schnommus/EMC_5uH_LISN/5uH_LISN.kicad_pcb

## KiCad design 5uH_LISN.kicad_pcb (2024-11-13)

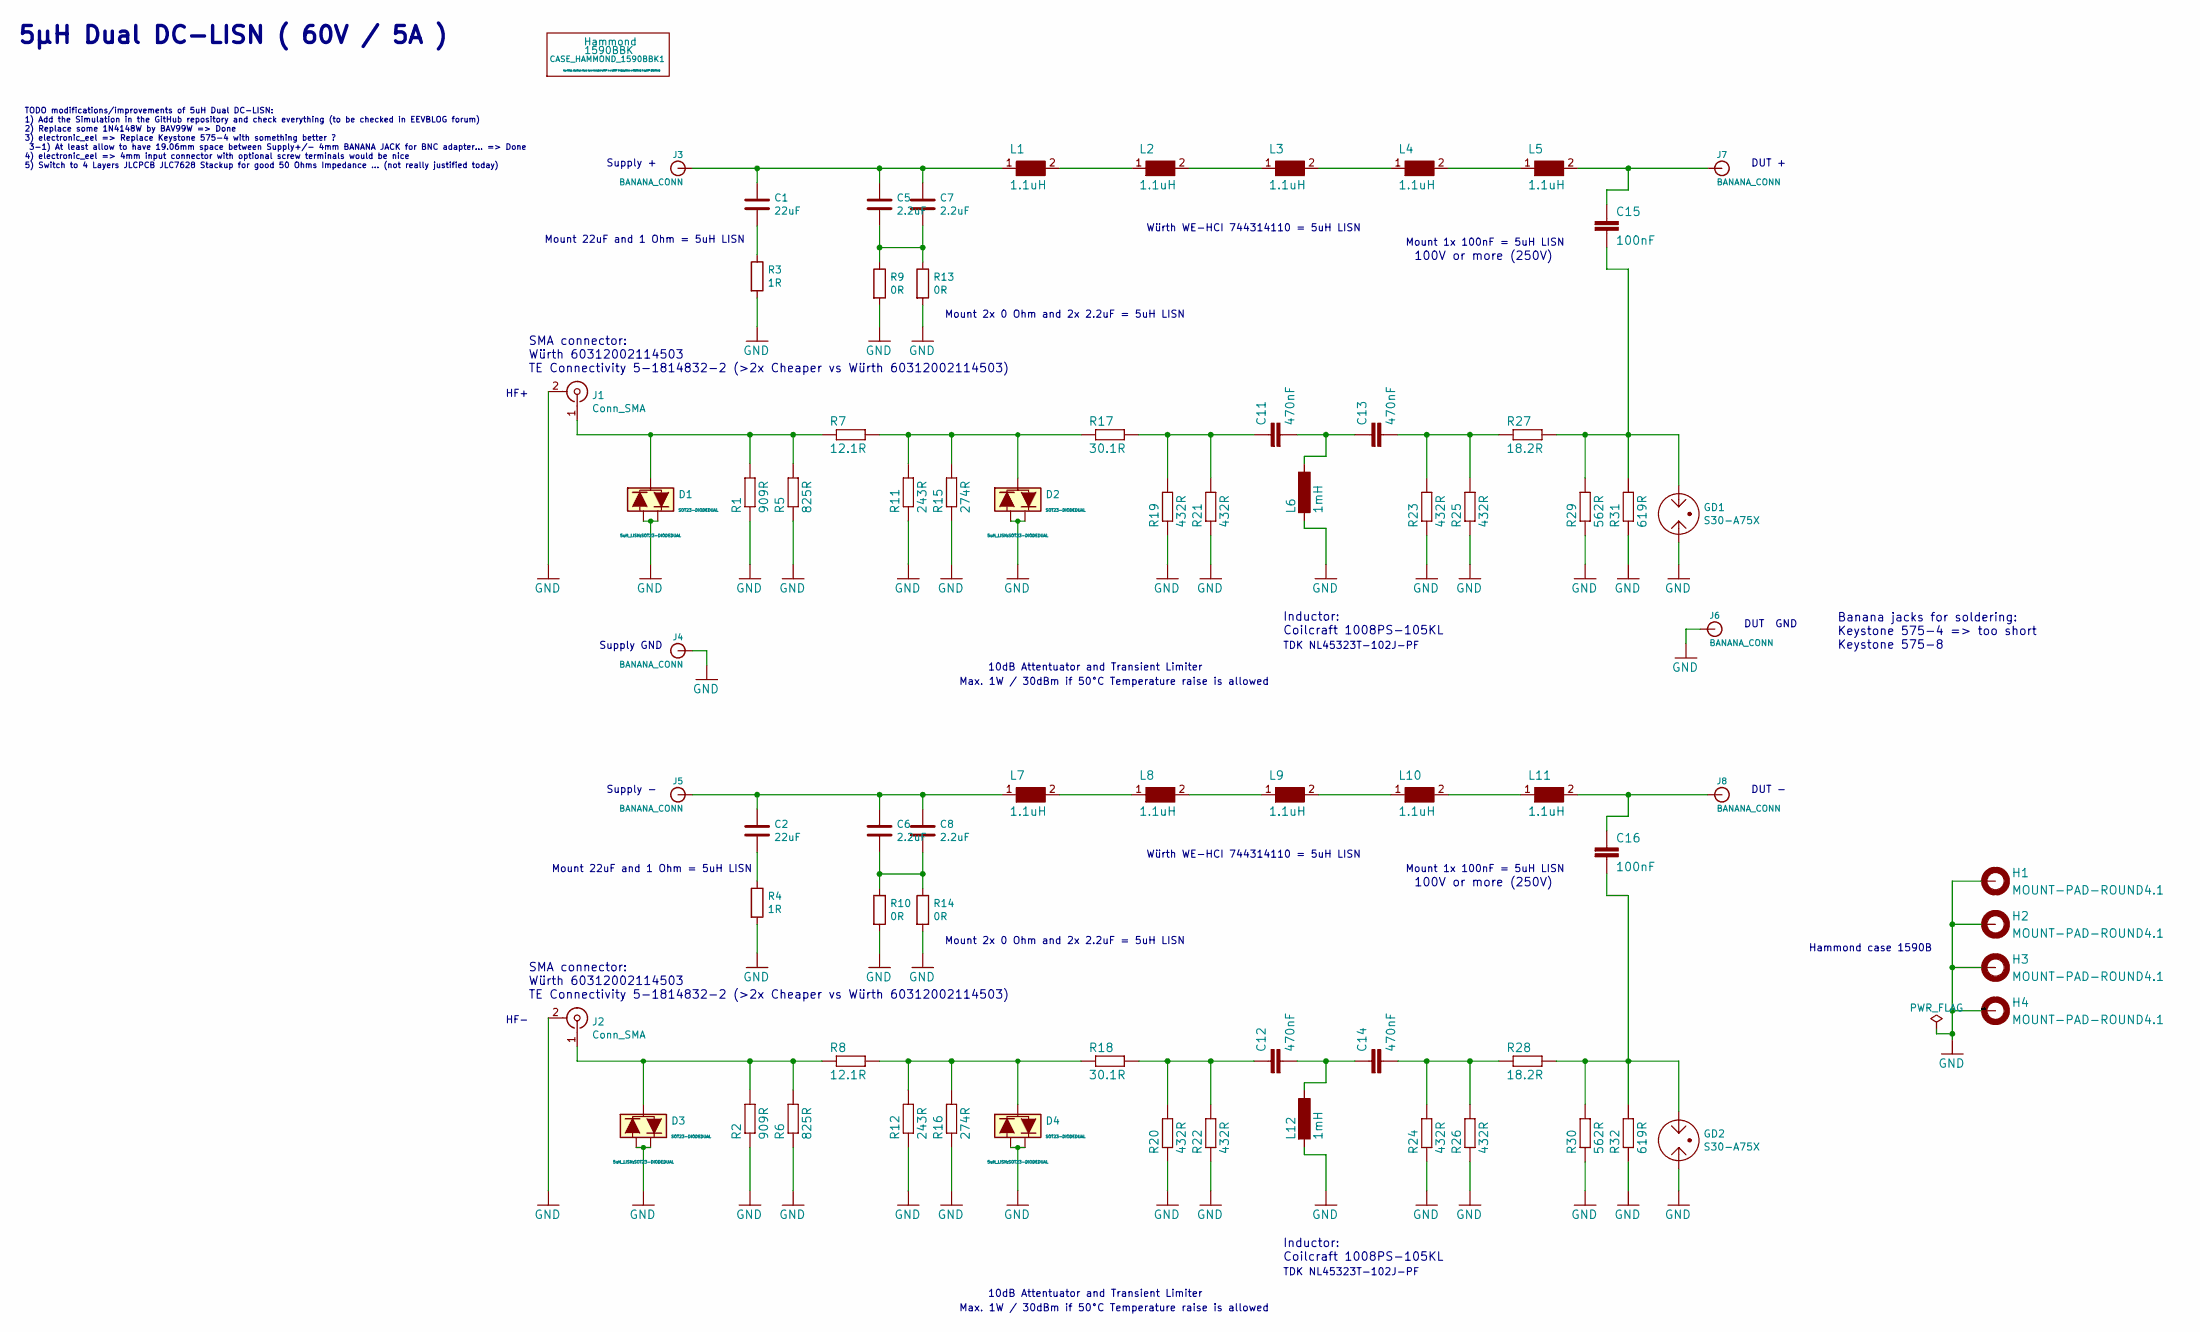
[picture p1: schematic 5uH_LISN.kicad_sch, Dual 5uH LISN]

Parts:
C1, C2: 22uF; C_2220_5650Metric
C5, C6, C7, C8: 2.2uF; C_1210_3225Metric
C11, C12, C13, C14: 470nF; C_0805_2012Metric
C15, C16: 100nF; C_1206_3216Metric
CASE_HAMMOND_1590BBK1: (no value)
D1, D2, D3, D4: SOT23-DIODEDUAL; LCSC C2500
GD1, GD2: S30-A75X; S30-A400X
H1, H2, H3, H4: MOUNT-PAD-ROUND4.1; 4,1-PAD
J1, J2: Conn_SMA; SMA_Wurth_60312002114503_Vertical
J3, J4, J5, J6, J7, J8: BANANA_CONN
L1, L2, L3, L4, L5, L7, L8, L9, L10, L11: 1.1uH; WE-HCI_7030_7040_7050
L6, L12: 1mH; COILCRAFT_1008PS
R1, R2: 909R; R_0805_2012Metric
R3, R4: 1R; R_1218_3246Metric
R5, R6: 825R; R_0805_2012Metric
R7, R8: 12.1R; R_1206_3216Metric
R9, R10, R13, R14: 0R; R_1206_3216Metric
R11, R12: 243R; R_0805_2012Metric
R15, R16: 274R; R_0805_2012Metric
R17, R18: 30.1R; R_1206_3216Metric
R19, R20, R21, R22, R23, R24, R25, R26: 432R; R_0805_2012Metric
R27, R28: 18.2R; R_1206_3216Metric
R29, R30: 562R; R_0805_2012Metric
R31, R32: 619R; R_0805_2012Metric

Connections:
GND: D1.1, D1.2, D2.1, D2.2, D3.1, D3.2, D4.1, D4.2, GD1.1, GD2.1, H1.B4,1 (MOUNT), H2.B4,1 (MOUNT), H3.B4,1 (MOUNT), H4.B4,1 (MOUNT), J1.2 (Ext), J2.2 (Ext), J4.P$1 (1), J6.P$1 (1), L6.P$2 (2), L12.P$2 (2), R1.1, R2.1, R3.2, R4.2, R5.1, R6.1, R9.2, R10.2, R11.1, R12.1, R13.2, R14.2, R15.1, R16.1, R19.1, R20.1, R21.1, R22.1, R23.1, R24.1, R25.1, R26.1, R29.1, R30.1, R31.1, R32.1
unnamed: C1.1, C5.1, C7.1, J3.P$1 (1), L1.1
unnamed: C1.2, R3.1
unnamed: C2.1, C6.1, C8.1, J5.P$1 (1), L7.1
unnamed: C2.2, R4.1
unnamed: C5.2, C7.2, R9.1, R13.1
unnamed: C6.2, C8.2, R10.1, R14.1
unnamed: C11.1, R17.2, R19.2, R21.2
unnamed: C11.2, C13.1, L6.P$1 (1)
unnamed: C12.1, R18.2, R20.2, R22.2
unnamed: C12.2, C14.1, L12.P$1 (1)
unnamed: C13.2, R23.2, R25.2, R27.1
unnamed: C14.2, R24.2, R26.2, R28.1
unnamed: C15.1, J7.P$1 (1), L5.2
unnamed: C15.2, GD1.2, R27.2, R29.2, R31.2
unnamed: C16.1, J8.P$1 (1), L11.2
unnamed: C16.2, GD2.2, R28.2, R30.2, R32.2
unnamed: D1.3, J1.1 (In), R1.2, R5.2, R7.1
unnamed: D2.3, R7.2, R11.2, R15.2, R17.1
unnamed: D3.3, J2.1 (In), R2.2, R6.2, R8.1
unnamed: D4.3, R8.2, R12.2, R16.2, R18.1
unnamed: L1.2, L2.1
unnamed: L2.2, L3.1
unnamed: L3.2, L4.1
unnamed: L4.2, L5.1
unnamed: L7.2, L8.1
unnamed: L8.2, L9.1
unnamed: L9.2, L10.1
unnamed: L10.2, L11.1

Notes on the sheet:
10dB Attentuator and Transient Limiter
Inductor: Coilcraft 1008PS-105KL
Supply -
100V or more (250V)
SMA connector: Würth 60312002114503 TE Connectivity 5-1814832-2 (>2x Cheaper vs Würth 60312002114503)
Max. 1W / 30dBm if 50°C Temperature raise is allowed
Würth WE-HCI 744314110 = 5uH LISN
Mount 1x 100nF = 5uH LISN
5µH Dual DC-LISN ( 60V / 5A )
Mount 22uF and 1 Ohm = 5uH LISN
TDK NL45323T-102J-PF
DUT +
Supply +
DUT GND
Mount 2x 0 Ohm and 2x 2.2uF = 5uH LISN
Hammond case 1590B
TODO modifications/improvements of 5uH Dual DC-LISN: 1) Add the Simulation in the GitHub repository and check everything (to be checked in EEVBLOG forum) 2) Replace some 1N4148W by BAV99W => Done 3) electronic_eel => Replace Keystone 575-4 with something better ? 3-1) At least allow to have 19.06mm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
Banana jacks for soldering: Keystone 575-4 => too short Keystone 575-8
Supply GND
HF-
HF+
DUT -

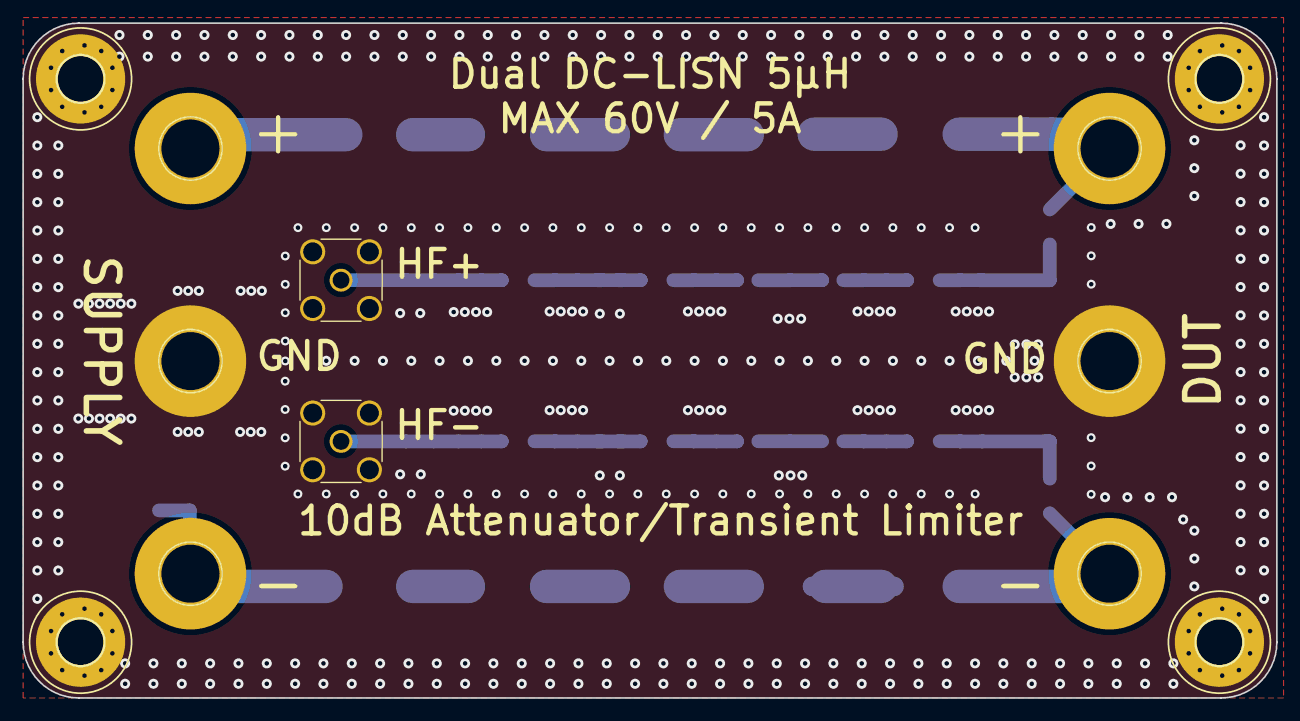
[picture p2: board 5uH_LISN.kicad_pcb from above]

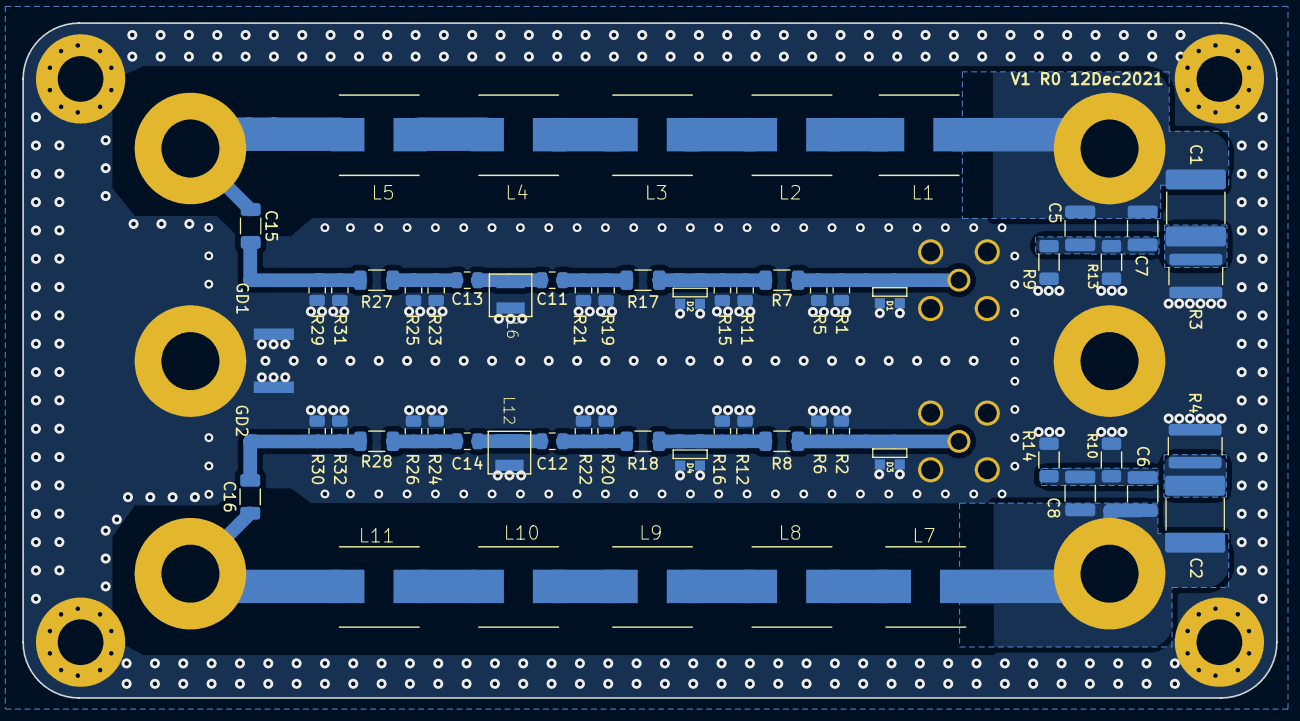
[picture p3: board 5uH_LISN.kicad_pcb from below]

Board: 2 copper layers, 112.4 x 60.5 mm, 74 parts (62 on the bottom side), 29 nets.
