schnommus/EMC_5uH_LISN/(commit log)

2024-11-13 fab for jlc 13.11.24
    [5uH_LISN-CuBottom.gbr, 5uH_LISN-CuTop.gbr, 5uH_LISN-EdgeCuts.gbr, 5uH_LISN-MaskBottom.gbr, 5uH_LISN-MaskTop.gbr, 5uH_LISN-NPTH.drl, 5uH_LISN-PTH.drl, 5uH_LISN-PasteBottom.gbr]
2024-11-13 missed files
    [5uH_LISN.kicad_pcb, 5uH_LISN.kicad_sch]
